johannes85/laserplotter/README.md

Laserplotter
============
DIY laserplotter controlled by an Arduino

Project page:  
http://www.domestichacks.info/projekte/laserplotter/
