johannes85/laserplotter/xyshield2/schematics/xyshield_final.brd

## EAGLE design xyshield2/schematics/xyshield_final.brd (2014-03-27)

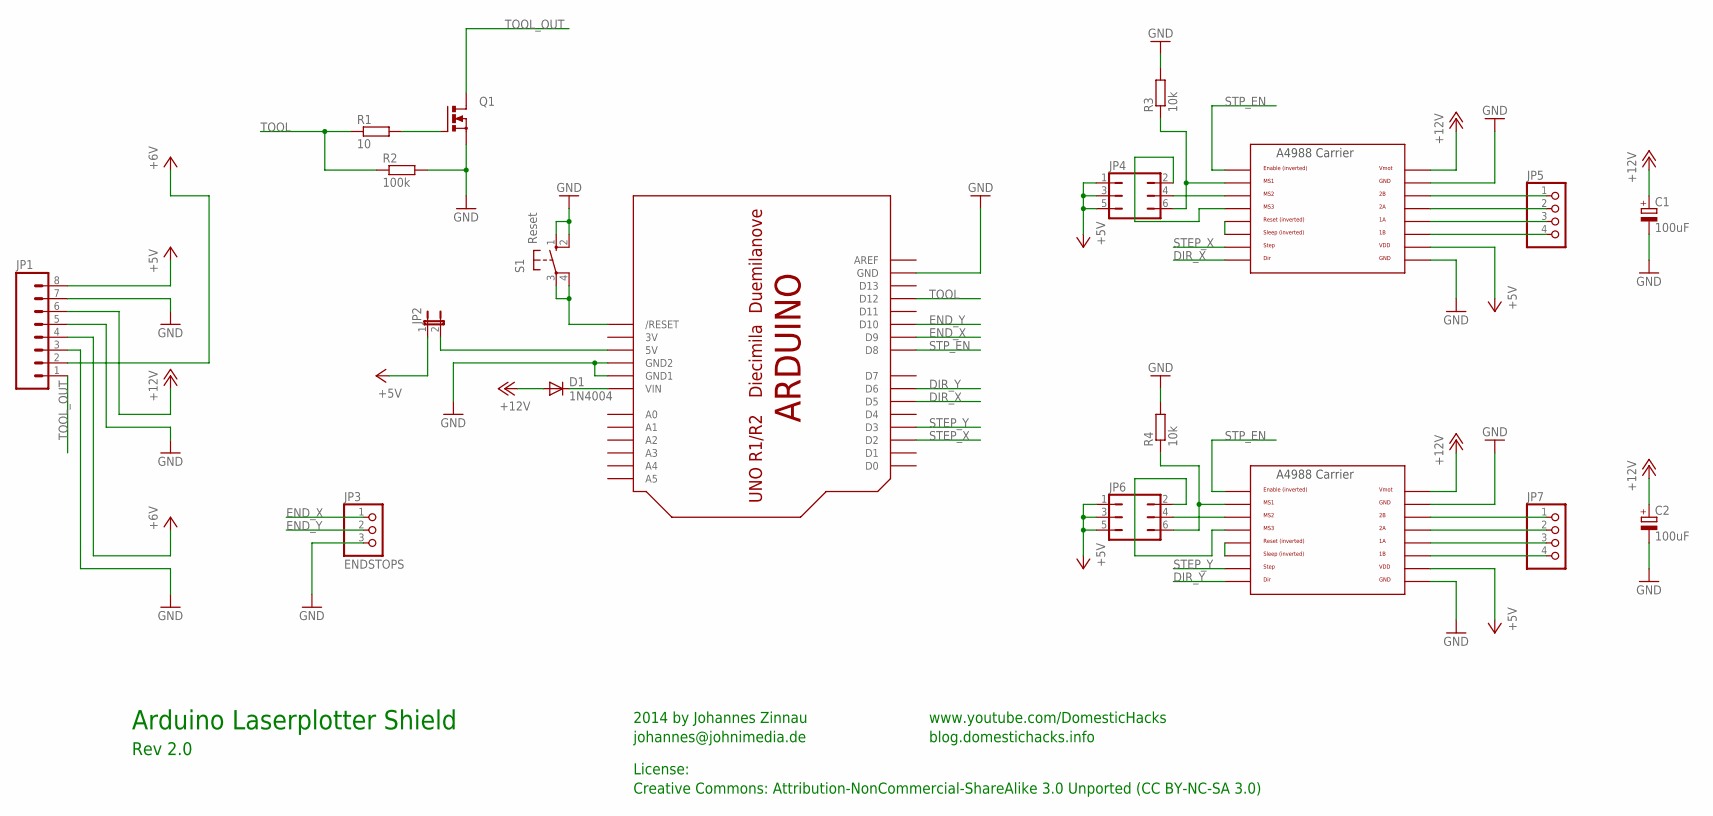
[picture p1: schematic xyshield_final.sch]

Parts:
C1, C2: 100uF; E2,5-6
D1: 1N4004; DO41-10
JP1: M083.5MM-8; SCREWTERMINAL-3.5MM-8
JP2: JUMPER-2PTH; 1X02
JP3: ENDSTOPS; 1X03
JP4, JP6: JP3Q
JP5, JP7: PINHD-1X4; 1X04
Q1: PMOSFET_NTO220BV; TO220BV
R1: 10; 0207/10
R2: 100k; 0207/10
R3, R4: 10k; 0207/2V
S1: Reset; B3F-10XX
U$1, U$2: POLOLU_A4983CARRIER; A4988BREAKOUT
U$3: ARDUINOUNO; ARDUINO

Connections:
3V: U$3.3V
+5V: JP1.8, JP2.1, JP4.1, JP4.3, JP4.5, JP6.1, JP6.3, JP6.5, U$1.VDD, U$2.VDD
+12V: C1.+, C2.+, D1.A, JP1.6, U$1.VMOT, U$2.VMOT
DIR_X: U$1.DIR, U$3.D5
DIR_Y: U$2.DIR, U$3.D6
END_X: JP3.1, U$3.D9
END_Y: JP3.2, U$3.D10
GND: C1.-, C2.-, JP1.3, JP1.5, JP1.7, JP3.3, Q1.S, R2.2, R3.2, R4.2, S1.1 (S), S1.2 (S1), U$1.GND, U$1.GND@0 (GND), U$2.GND, U$2.GND@0 (GND), U$3.GND, U$3.GND1, U$3.GND2
unnamed: Q1.G, R1.2
unnamed: U$1.RST, U$1.SLP (SLEEP)
unnamed: JP5.3, U$1.1A
unnamed: JP5.2, U$1.2A
unnamed: JP5.1, U$1.2B
unnamed: JP5.4, U$1.1B
unnamed: JP4.6, R3.1, U$1.MS1
unnamed: JP4.4, U$1.MS2
unnamed: JP4.2, U$1.MS3
unnamed: U$2.RST, U$2.SLP (SLEEP)
unnamed: JP7.4, U$2.1B
unnamed: JP7.3, U$2.1A
unnamed: JP7.2, U$2.2A
unnamed: JP7.1, U$2.2B
unnamed: JP6.6, R4.1, U$2.MS1
unnamed: JP6.4, U$2.MS2
unnamed: JP6.2, U$2.MS3
unnamed: JP2.2, U$3.5V
unnamed: D1.C, U$3.VIN
unnamed: S1.3, S1.4 (P1), U$3.RESET (/RESET)
STEP_X: U$1.STEP, U$3.D2
STEP_Y: U$2.STEP, U$3.D3
STP_EN: U$1.EN, U$2.EN, U$3.D8
TOOL: R1.1, R2.1, U$3.D12
TOOL_OUT: JP1.1, Q1.D
VCC: JP1.2, JP1.4

Notes on the sheet:
Arduino Laserplotter Shield
Rev 2.0
2014 by Johannes Zinnau
johannes@johnimedia.de
www.youtube.com/DomesticHacks
blog.domestichacks.info
License:
Creative Commons: Attribution-NonCommercial-ShareAlike 3.0 Unported (CC BY-NC-SA 3.0)

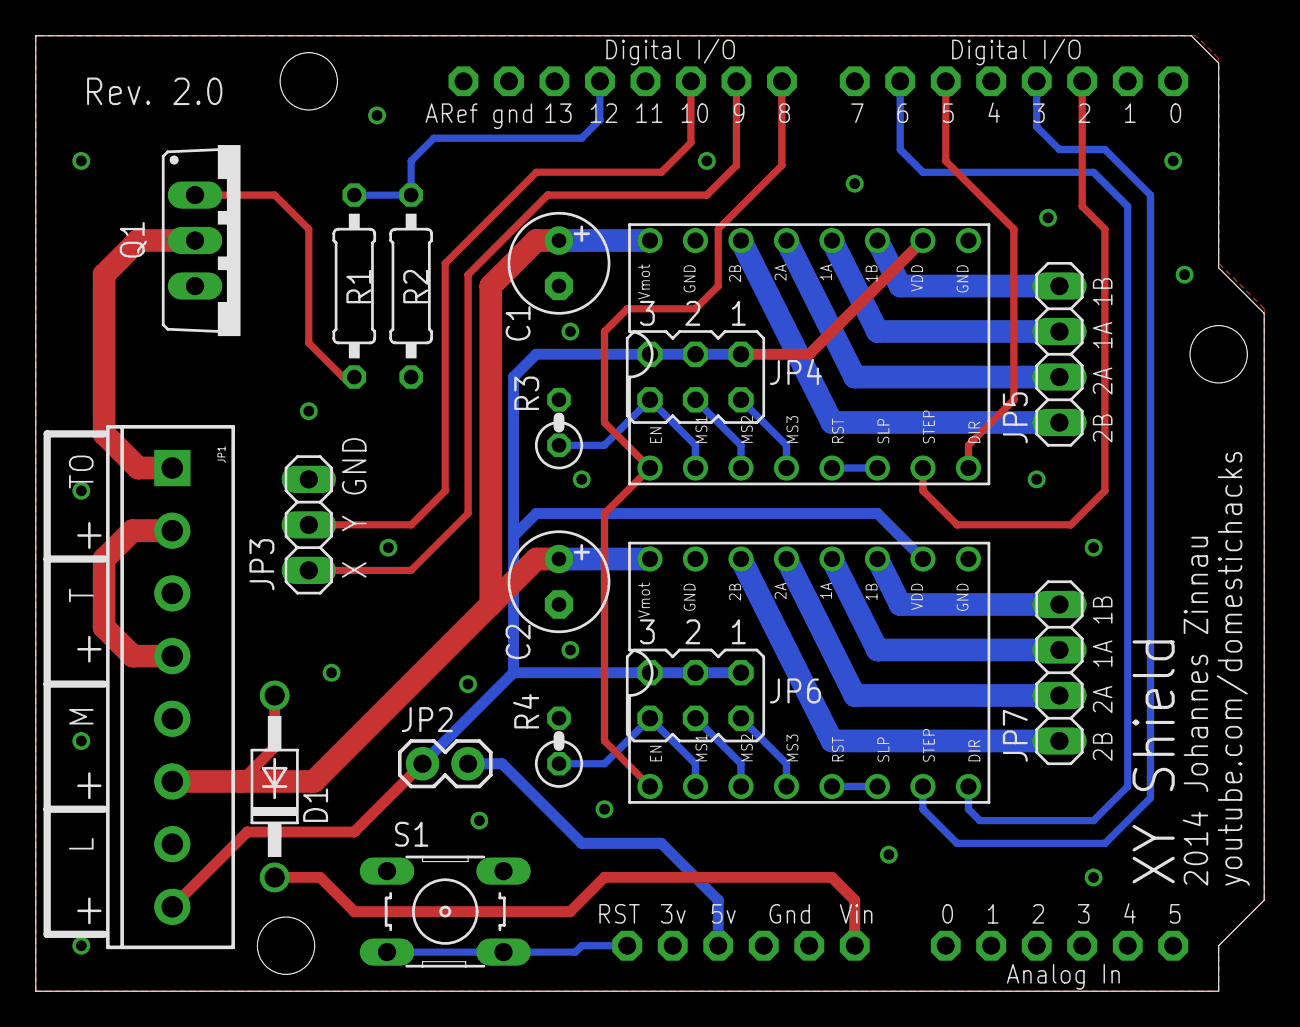
[picture p2: board xyshield_final.brd from above]

Board: 2 copper layers, 68.6 x 53.3 mm, 19 parts (0 on the bottom side), 33 nets.
