johannes85/laserplotter/xyshield/xyshield.brd

## EAGLE design xyshield/xyshield.brd (2013-12-19)

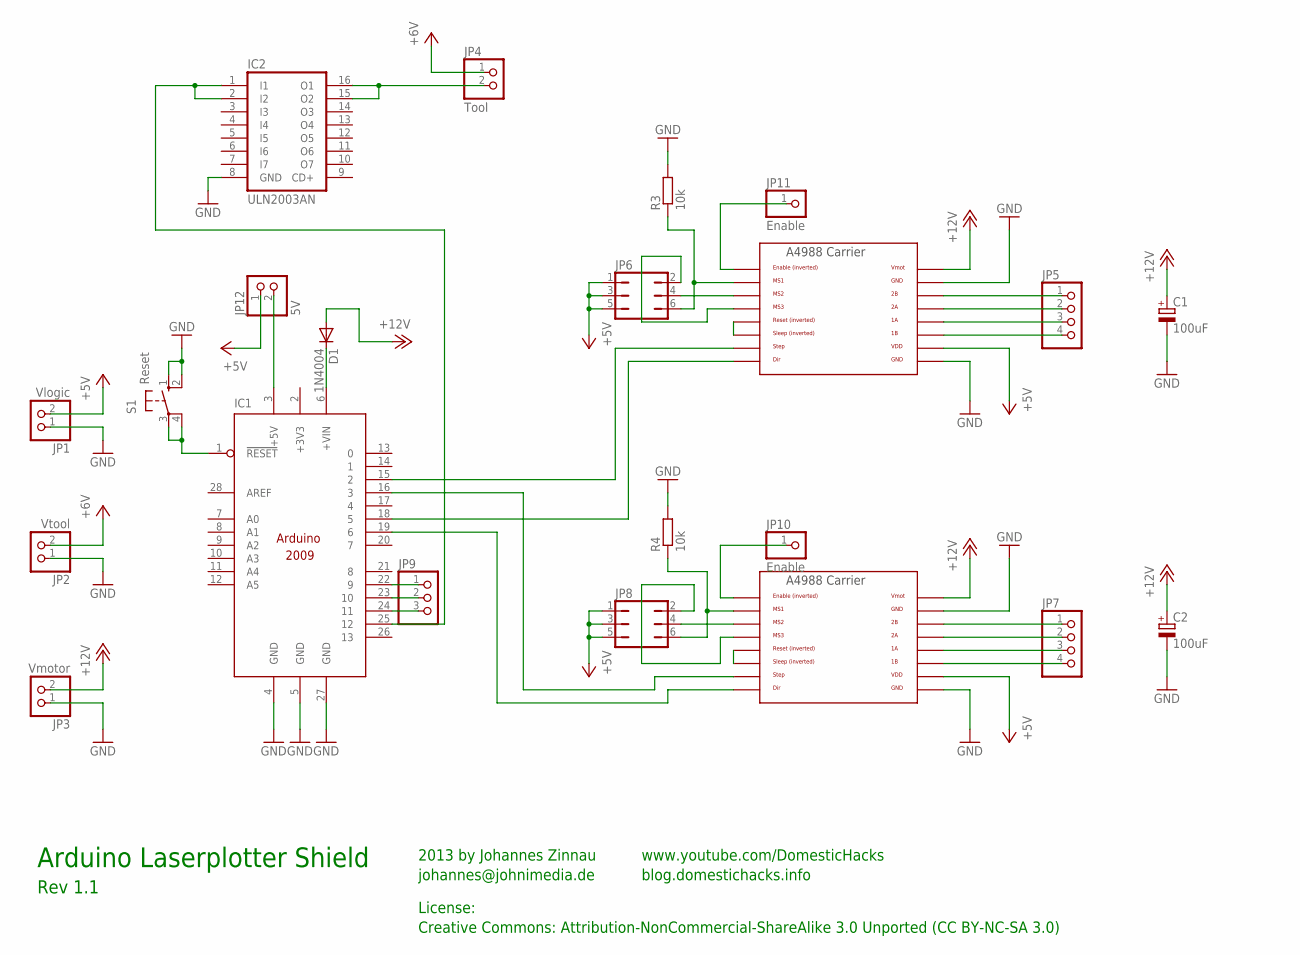
[picture p3: schematic xyshield.sch]

Parts:
C1, C2: 100uF; E2,5-6
D1: 1N4004; DO41-10
IC1: Arduino; ARDUINO2009
IC2: ULN2003AN; DIL16
JP1: Vlogic; 1X02
JP2: Vtool; 1X02
JP3: Vmotor; 1X02
JP4: Tool; 1X02
JP5, JP7: PINHD-1X4; 1X04
JP6, JP8: JP3Q
JP9: PINHD-1X3; 1X03
JP10, JP11: Enable; 1X01
JP12: 5V; 1X02
R3, R4: 10k; 0204V
S1: Reset; B3F-10XX
U$1, U$2: POLOLU_A4983CARRIER; A4988BREAKOUT

Connections:
+3V3: IC1.2 (+3V3)
+5V: JP1.2, JP6.1, JP6.3, JP6.5, JP8.1, JP8.3, JP8.5, JP12.1, U$1.VDD, U$2.VDD
+12V: C1.+, C2.+, D1.A, JP3.2, U$1.VMOT, U$2.VMOT
GND: C1.-, C2.-, IC1.4 (GND), IC1.5 (GND), IC1.27 (GND), IC2.8 (GND), JP1.1, JP2.1, JP3.1, R3.2, R4.2, S1.1 (S), S1.2 (S1), U$1.GND, U$1.GND@0 (GND), U$2.GND, U$2.GND@0 (GND)
unnamed: IC1.25 (12), IC2.1 (I1), IC2.2 (I2)
unnamed: IC2.15 (O2), IC2.16 (O1), JP4.2
unnamed: U$1.RST, U$1.SLP (SLEEP)
unnamed: JP5.3, U$1.1A
unnamed: JP5.2, U$1.2A
unnamed: JP5.1, U$1.2B
unnamed: JP5.4, U$1.1B
unnamed: JP6.6, R3.1, U$1.MS1
unnamed: JP6.4, U$1.MS2
unnamed: JP6.2, U$1.MS3
unnamed: U$2.RST, U$2.SLP (SLEEP)
unnamed: JP7.4, U$2.1B
unnamed: JP7.3, U$2.1A
unnamed: JP7.2, U$2.2A
unnamed: JP7.1, U$2.2B
unnamed: JP8.6, R4.1, U$2.MS1
unnamed: JP8.4, U$2.MS2
unnamed: JP8.2, U$2.MS3
unnamed: IC1.15 (2), U$1.STEP
unnamed: IC1.18 (5), U$1.DIR
unnamed: IC1.16 (3), U$2.STEP
unnamed: IC1.19 (6), U$2.DIR
unnamed: IC1.22 (9), JP9.1
unnamed: IC1.23 (10), JP9.2
unnamed: IC1.24 (11), JP9.3
unnamed: JP11.1, U$1.EN
unnamed: JP10.1, U$2.EN
unnamed: IC1.1 (!RESET), S1.3, S1.4 (P1)
unnamed: D1.C, IC1.6 (+VIN)
unnamed: IC1.3 (+5V), JP12.2
VCC: JP2.2, JP4.1

Notes on the sheet:
Arduino Laserplotter Shield
Rev 1.1
2013 by Johannes Zinnau
johannes@johnimedia.de
www.youtube.com/DomesticHacks
blog.domestichacks.info
License:
Creative Commons: Attribution-NonCommercial-ShareAlike 3.0 Unported (CC BY-NC-SA 3.0)

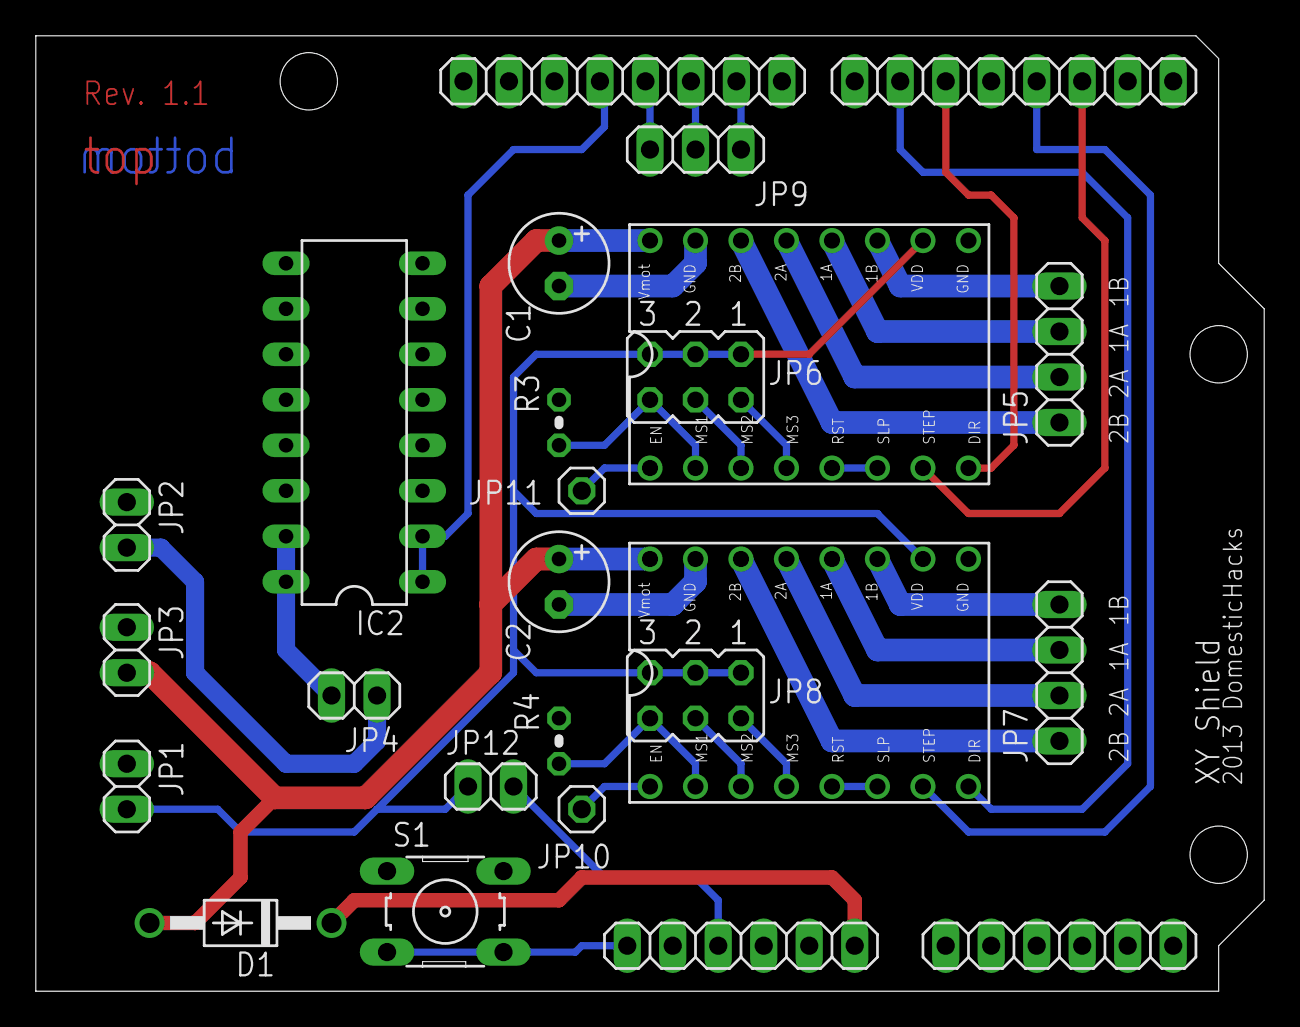
[picture p4: board xyshield.brd from above]

Board: 2 copper layers, 68.6 x 53.3 mm, 22 parts (0 on the bottom side), 34 nets.
