johannes85/laserplotter/(commit log)

2013-12-19 Added Arduino shield schematics
    [xyshield.brd, xyshield.sch]
2014-03-27 Board version 2
2014-03-27 Board version 2 schematics
    [xyshield_final.brd, xyshield_final.sch]
